ProximaAerospace/FlightComputersHardware/Main_Board/3D Models/THVD1450DRBR.stp

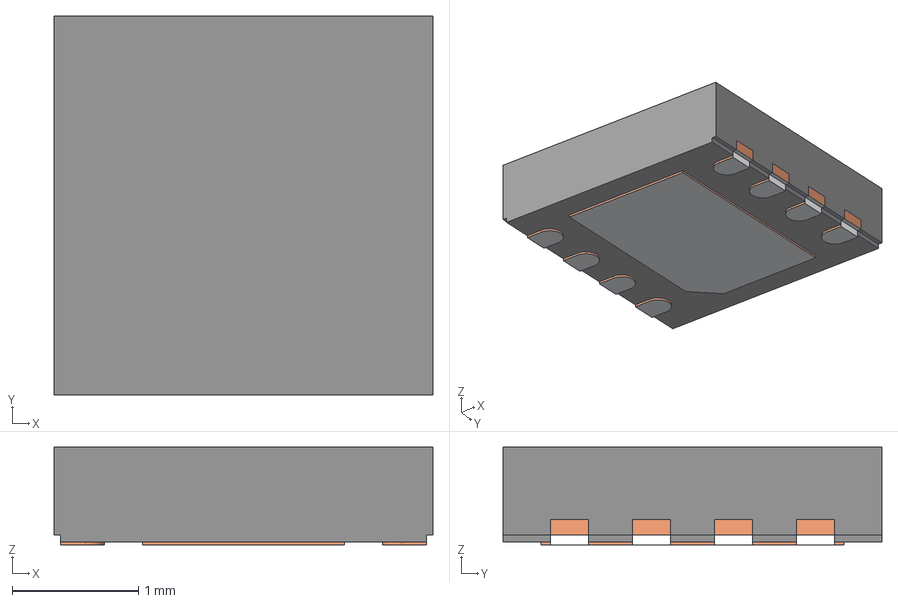
[picture p1: CAD file, 2026-09-14]
Main_Board/3D Models/THVD1450DRBR.stp
3.00 x 3.00 x 0.775 mm
BODY-SON_AF0
FRAME-DRB0008F_AF0
