ProximaAerospace/FlightComputersHardware/Main_Board/3D Models/LQH3NPN1R5MJRL.STEP

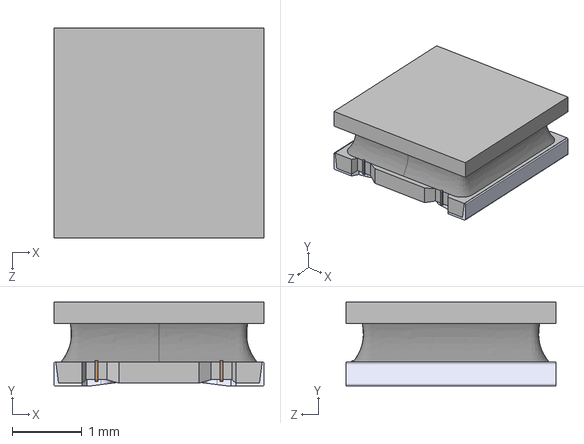
[picture p2: CAD file, 2026-08-05]
Main_Board/3D Models/LQH3NPN1R5MJRL.STEP
3.00 x 1.20 x 3.00 mm
