ProximaAerospace/FlightComputersHardware/Main_Board/3D Models/ESP32-S3-MINI-1U-N8--3DModel-STEP-56544.STEP

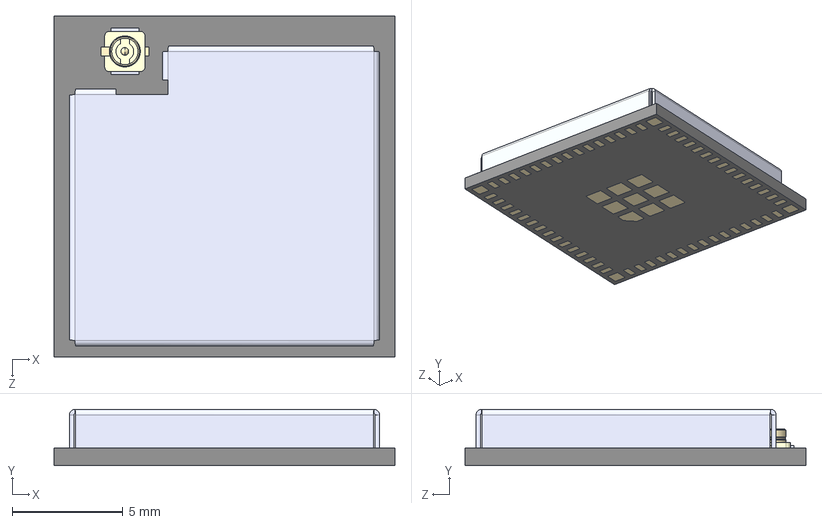
[picture p3: CAD file, 2026-08-05]
Main_Board/3D Models/ESP32-S3-MINI-1U-N8--3DModel-STEP-56544.STEP
15.4 x 2.55 x 15.4 mm
ESP32-S3-MINI-1U-N8_ESP32-C3-MINI-1-N4
antenna jack
