ProximaAerospace/FlightComputersHardware/Main_Board/Main_Board.kicad_pcb

## KiCad design Main_Board/Main_Board.kicad_pcb (2026-09-14)

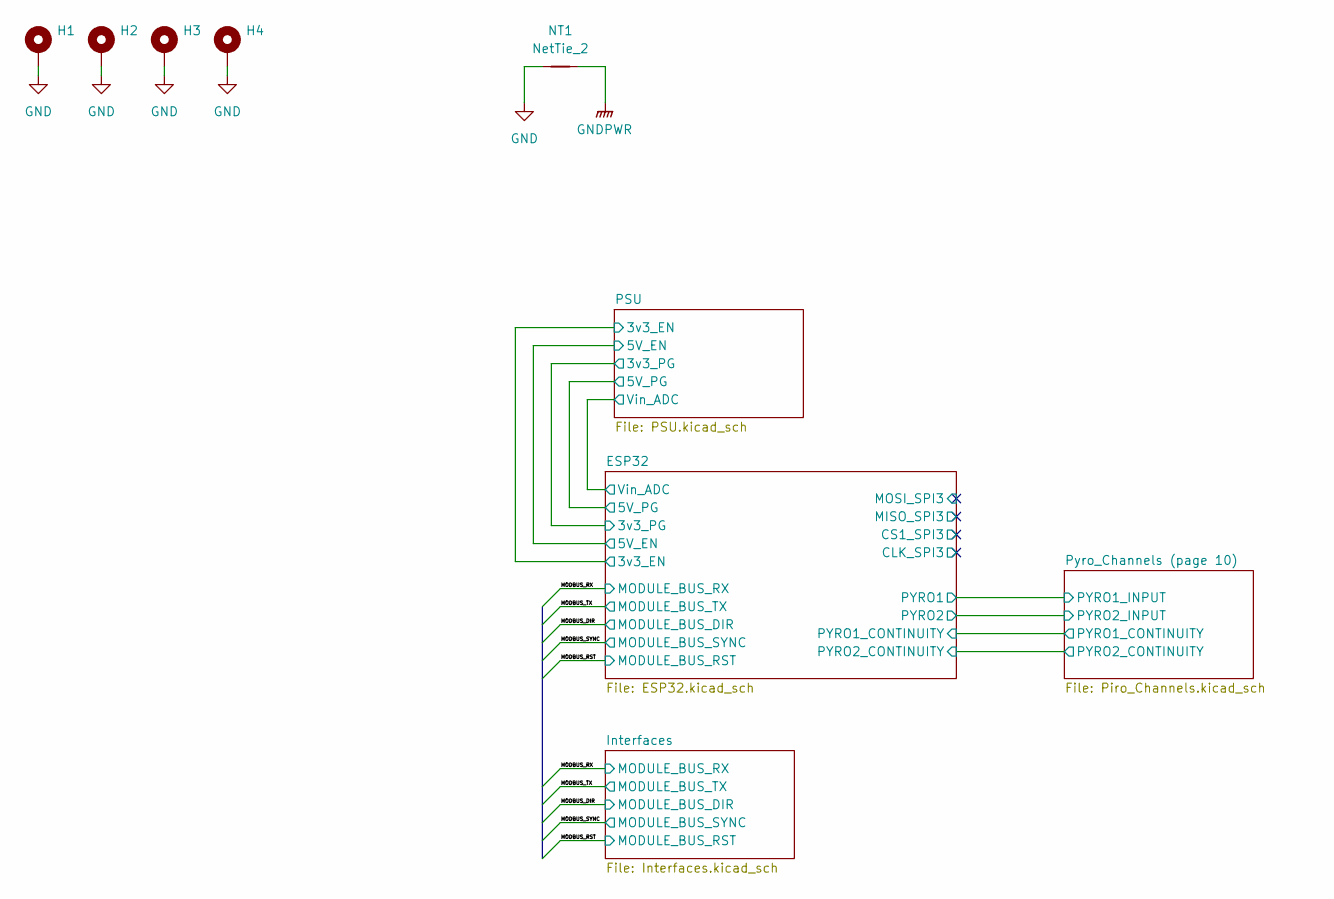
[picture p4: schematic Main_Board.kicad_sch]

Parts:
H1, H2: MountingHole_Pad; MountingHole_3.2mm_M3_DIN965_Pad_TopBottom
H3, H4: MountingHole_Pad; MountingHole_2.2mm_M2
NT1: NetTie_2; NetTie-2_SMD_Pad2.0mm

Connections:
GND: H1.1 (1_1), H2.1 (1_1), H3.1, H4.1, NT1.1; also elsewhere on the board
GNDPWR: NT1.2; also elsewhere on the board

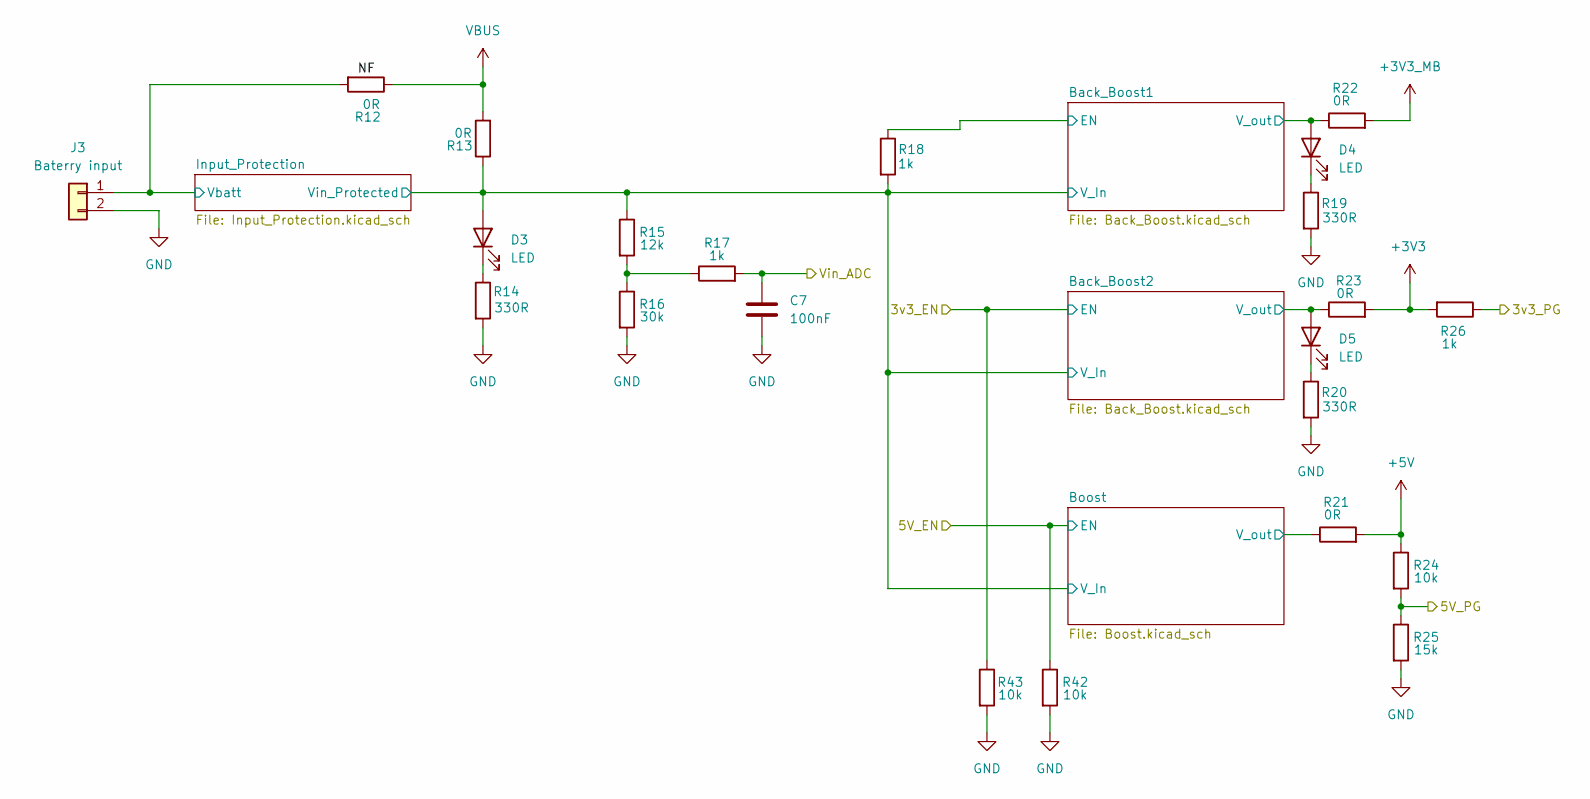
[picture p5: schematic PSU.kicad_sch]

Parts:
C7: 100nF; C_0603_1608Metric
D3, D4, D5: LED; D_0603_1608Metric
J3: Baterry input; JST_PH_B2B-PH-K_1x02_P2.00mm_Vertical
R12, R21, R22, R23: 0R; R_0603_1608Metric
R13: 0R; R_0805_2012Metric
R14, R19, R20: 330R; R_0603_1608Metric
R15: 12k; R_0603_1608Metric
R16: 30k; R_0603_1608Metric
R17, R18, R26: 1k; R_0603_1608Metric
R24, R42, R43: 10k; R_0603_1608Metric
R25: 15k; R_0603_1608Metric

Connections:
+3V3: R23.2, R26.2; also elsewhere on the board
+3V3_MB: R22.2; also elsewhere on the board
+5V: R21.2, R24.1; also elsewhere on the board
/ESP32/3v3_EN: R43.1; also elsewhere on the board
/ESP32/3v3_PG: R26.1; also elsewhere on the board
/ESP32/5V_EN: R42.1; also elsewhere on the board
/ESP32/5V_PG: R24.2, R25.1; also elsewhere on the board
/ESP32/Vin_ADC: C7.1, R17.2; also elsewhere on the board
/PSU/Back_Boost1/EN: R18.1; also elsewhere on the board
/PSU/Back_Boost1/V_In: D3.2 (A), R13.1, R15.1, R18.2; also elsewhere on the board
/PSU/Back_Boost1/V_out: D4.2 (A), R22.1; also elsewhere on the board
/PSU/Back_Boost2/V_out: D5.2 (A), R23.1; also elsewhere on the board
/PSU/Boost/V_out: R21.1; also elsewhere on the board
/PSU/Input_Protection/Vbatt: J3.1, R12.2; also elsewhere on the board
GND: C7.2, J3.2, R14.2, R16.2, R19.2, R20.2, R25.2, R42.2, R43.2; also elsewhere on the board
unnamed: D3.1 (K), R14.1
unnamed: D4.1 (K), R19.1
unnamed: D5.1 (K), R20.1
unnamed: R15.2, R16.1, R17.1
VBUS: R12.1, R13.2; also elsewhere on the board

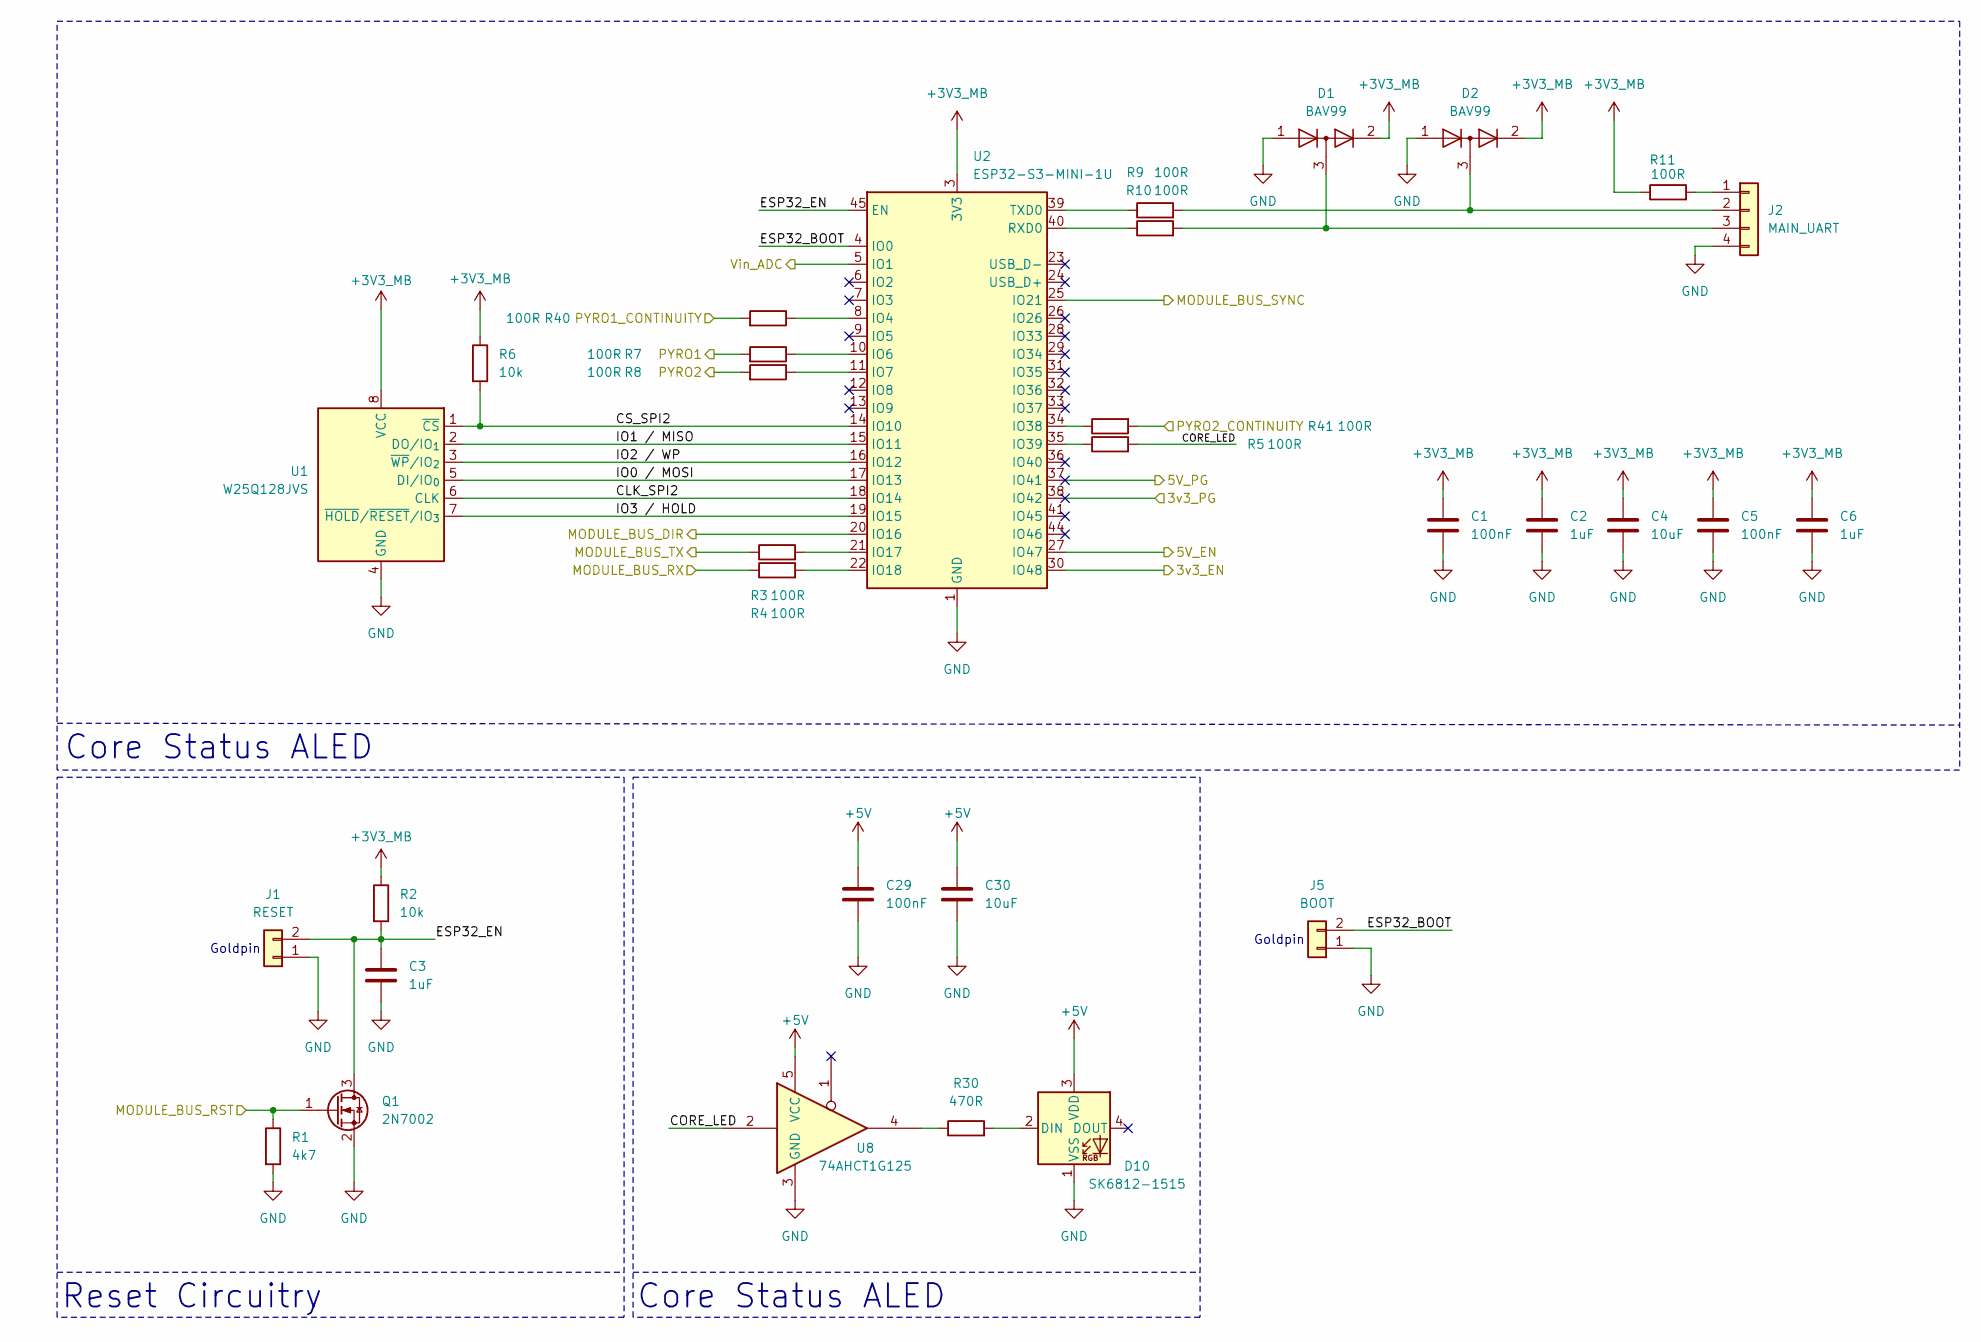
[picture p6: schematic ESP32.kicad_sch]

Parts:
C1, C5, C29: 100nF; C_0603_1608Metric
C2, C3, C6: 1uF; C_0603_1608Metric
C4, C30: 10uF; C_0603_1608Metric
D1, D2: BAV99; SOT-23
D10: SK6812-1515; sk68015-1515
J1: RESET; PinHeader_1x02_P1.27mm_Vertical
J2: MAIN_UART; PinHeader_1x04_P2.54mm_Vertical
J5: BOOT; PinHeader_1x02_P1.27mm_Vertical
Q1: 2N7002; SOT-23
R1: 4k7; R_0603_1608Metric
R2, R6: 10k; R_0603_1608Metric
R3, R4, R5, R7, R8, R9, R10, R11, R40, R41: 100R; R_0603_1608Metric
R30: 470R; R_0603_1608Metric
U1: W25Q128JVS; SOIC-8_5.3x5.3mm_P1.27mm
U2: ESP32-S3-MINI-1U; ESP32-S2-MINI-1U
U8: 74AHCT1G125; SOT-353_SC-70-5

Connections:
+3V3_MB: C1.1, C2.1, C4.1, C5.1, C6.1, D1.2 (A), D2.2 (A), R2.1, R6.1, R11.1, U1.8 (VCC), U2.3 (3V3); also elsewhere on the board
+5V: C29.1, C30.1, D10.3 (VDD), U8.5 (VCC); also elsewhere on the board
/ESP32/3v3_EN: U2.30 (IO48); also elsewhere on the board
/ESP32/3v3_PG: U2.38 (IO42); also elsewhere on the board
/ESP32/5V_EN: U2.27 (IO47); also elsewhere on the board
/ESP32/5V_PG: U2.37 (IO41); also elsewhere on the board
/ESP32/CLK_SPI2: U1.6 (CLK), U2.18 (IO14)
/ESP32/CORE_LED: R5.2, U8.2
/ESP32/CS_SPI2: R6.2, U1.1 (~CS), U2.14 (IO10)
/ESP32/ESP32_BOOT: J5.2, U2.4 (IO0)
/ESP32/ESP32_EN: C3.1, J1.2, Q1.3 (D), R2.2, U2.45 (EN)
/ESP32/IO0 / MOSI: U1.5 (DI/IO_{0}), U2.17 (IO13)
/ESP32/IO1 / MISO: U1.2 (DO/IO_{1}), U2.15 (IO11)
/ESP32/IO2 / WP: U1.3 (~WP/IO_{2}), U2.16 (IO12)
/ESP32/IO3 / HOLD: U1.7 (~HOLD/~RESET/IO_{3}), U2.19 (IO15)
/ESP32/PYRO1: R7.2; also elsewhere on the board
/ESP32/PYRO1_CONTINUITY: R40.2; also elsewhere on the board
/ESP32/PYRO2: R8.2; also elsewhere on the board
/ESP32/PYRO2_CONTINUITY: R41.2; also elsewhere on the board
/ESP32/Vin_ADC: U2.5 (IO1); also elsewhere on the board
/MODBUS_DIR: U2.20 (IO16); also elsewhere on the board
/MODBUS_RST: Q1.1 (G), R1.1; also elsewhere on the board
/MODBUS_RX: R4.1; also elsewhere on the board
/MODBUS_SYNC: U2.25 (IO21); also elsewhere on the board
/MODBUS_TX: R3.1; also elsewhere on the board
GND: C1.2, C2.2, C3.2, C4.2, C5.2, C6.2, C29.2, C30.2, D1.1 (K), D2.1 (K), D10.1 (VSS), J1.1, J2.4, J5.1, Q1.2 (S), R1.2, U1.4 (GND), U2.1 (GND), U2.2 (GND), U2.42 (GND), U2.43 (GND), U2.46 (GND), U2.47 (GND), U2.48 (GND), U2.49 (GND), U2.50 (GND), U2.51 (GND), U2.52 (GND), U2.53 (GND), U2.54 (GND), U2.55 (GND), U2.56 (GND), U2.57 (GND), U2.58 (GND), U2.59 (GND), U2.60 (GND), U2.61 (GND), U2.62 (GND), U2.63 (GND), U2.64 (GND), U2.65 (GND), U8.3 (GND); also elsewhere on the board
unnamed: D10.2 (DIN), R30.2
unnamed: J2.1, R11.2
unnamed: D2.3 (K), J2.2, R9.2
unnamed: D1.3 (K), J2.3, R10.2
unnamed: R30.1, U8.4
unnamed: R40.1, U2.8 (IO4)
unnamed: R7.1, U2.10 (IO6)
unnamed: R8.1, U2.11 (IO7)
unnamed: R3.2, U2.21 (IO17)
unnamed: R4.2, U2.22 (IO18)
unnamed: R41.1, U2.34 (IO38)
unnamed: R5.1, U2.35 (IO39)
unnamed: R10.1, U2.40 (RXD0)
unnamed: R9.1, U2.39 (TXD0)

Notes on the sheet:
Reset Circuitry
Goldpin
Core Status ALED

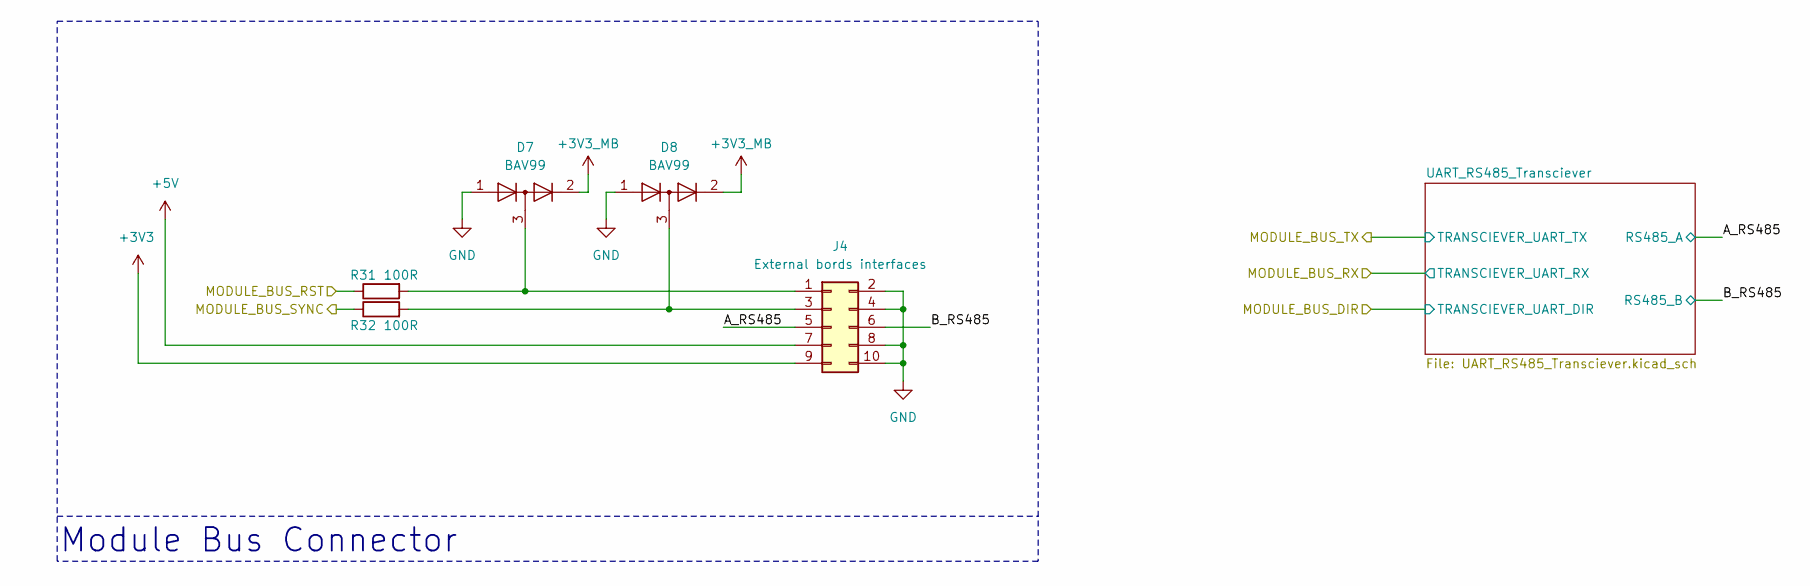
[picture p7: schematic Interfaces.kicad_sch]

Parts:
D7, D8: BAV99; SOT-23
J4: External bords interfaces; PinHeader_2x05_P1.27mm_Vertical
R31, R32: 100R; R_0603_1608Metric

Connections:
+3V3: J4.9; also elsewhere on the board
+3V3_MB: D7.2 (A), D8.2 (A); also elsewhere on the board
+5V: J4.7; also elsewhere on the board
/Interfaces/A_RS485: J4.5; also elsewhere on the board
/Interfaces/B_RS485: J4.6; also elsewhere on the board
/MODBUS_RST: R31.1; also elsewhere on the board
/MODBUS_SYNC: R32.1; also elsewhere on the board
GND: D7.1 (K), D8.1 (K), J4.2, J4.4, J4.8, J4.10; also elsewhere on the board
unnamed: D7.3 (K), J4.1, R31.2
unnamed: D8.3 (K), J4.3, R32.2

Notes on the sheet:
Module Bus Connector

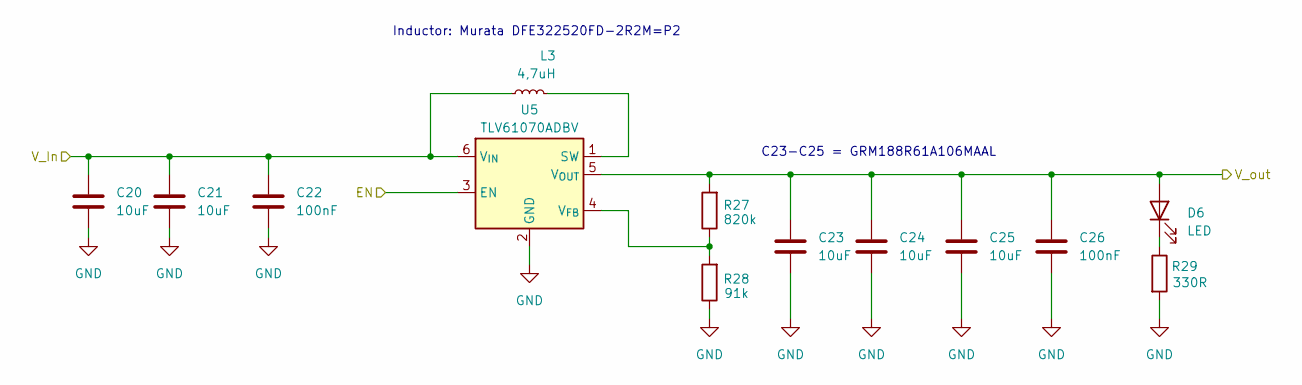
[picture p8: schematic Boost.kicad_sch]

Parts:
C20, C21, C23, C24, C25: 10uF; C_0603_1608Metric
C22, C26: 100nF; C_0603_1608Metric
D6: LED; D_0603_1608Metric
L3: 4,7uH; L_1210_3225Metric
R27: 820k; R_0603_1608Metric
R28: 91k; R_0603_1608Metric
R29: 330R; R_0603_1608Metric
U5: TLV61070ADBV; SOT-23-6

Connections:
/ESP32/5V_EN: U5.3 (EN); also elsewhere on the board
/PSU/Back_Boost1/V_In: C20.1, C21.1, C22.1, L3.2, U5.6 (V_{IN}); also elsewhere on the board
/PSU/Boost/V_out: C23.1, C24.1, C25.1, C26.1, D6.2 (A), R27.2, U5.5 (V_{OUT}); also elsewhere on the board
GND: C20.2, C21.2, C22.2, C23.2, C24.2, C25.2, C26.2, R28.1, R29.2, U5.2 (GND); also elsewhere on the board
unnamed: D6.1 (K), R29.1
unnamed: L3.1, U5.1 (SW)
unnamed: R27.1, R28.2, U5.4 (V_{FB})

Notes on the sheet:
Inductor: Murata DFE322520FD-2R2M=P2
C23-C25 = GRM188R61A106MAAL

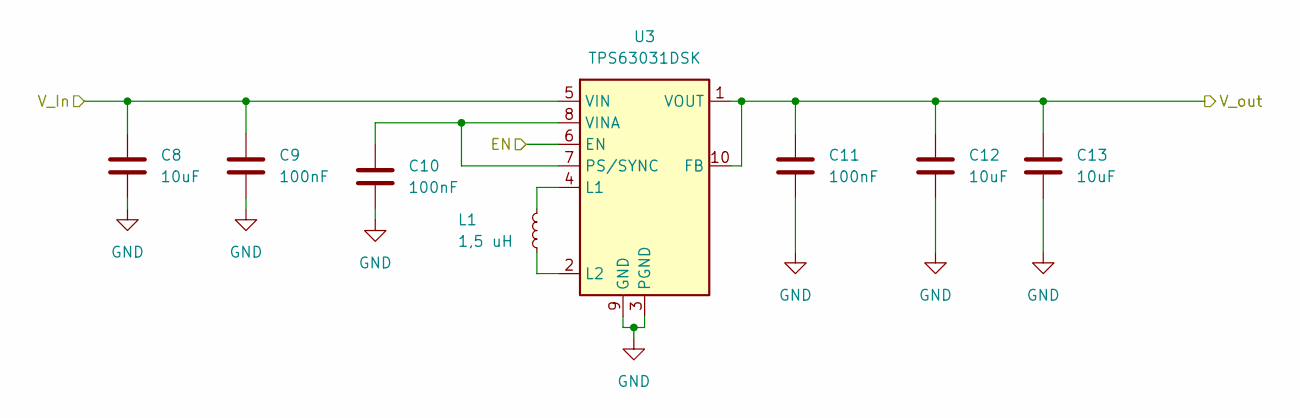
[picture p9: schematic Back_Boost.kicad_sch]

Parts:
C8, C12, C13: 10uF; C_0603_1608Metric
C9, C10, C11: 100nF; C_0603_1608Metric
L1: 1,5 uH; L_Taiyo-Yuden_MD-3030
U3: TPS63031DSK; WSON-10-1EP_2.5x2.5mm_P0.5mm_EP1.2x2mm

Connections:
/PSU/Back_Boost1/EN: U3.6 (EN); also elsewhere on the board
/PSU/Back_Boost1/V_In: C8.1, C9.1, U3.5 (VIN); also elsewhere on the board
/PSU/Back_Boost1/V_out: C11.1, C12.1, C13.1, U3.1 (VOUT), U3.10 (FB); also elsewhere on the board
GND: C8.2, C9.2, C10.2, C11.2, C12.2, C13.2, U3.3 (PGND), U3.9 (GND), U3.11 (PGND); also elsewhere on the board
unnamed: L1.1, U3.4 (L1)
unnamed: L1.2, U3.2 (L2)
unnamed: C10.1, U3.7 (PS/SYNC), U3.8 (VINA)

Parts of its further copies:
C14, C18, C19: 10uF; C_0603_1608Metric
C15, C16, C17: 100nF; C_0603_1608Metric
L2: 1,5 uH; L_Taiyo-Yuden_MD-3030
U4: TPS63031DSK; WSON-10-1EP_2.5x2.5mm_P0.5mm_EP1.2x2mm

Connections of its further copies:
/ESP32/3v3_EN: U4.6 (EN); also elsewhere on the board
/PSU/Back_Boost1/V_In: C14.1, C15.1, U4.5 (VIN); also elsewhere on the board
/PSU/Back_Boost2/V_out: C17.1, C18.1, C19.1, U4.1 (VOUT), U4.10 (FB); also elsewhere on the board
GND: C14.2, C15.2, C16.2, C17.2, C18.2, C19.2, U4.3 (PGND), U4.9 (GND), U4.11 (PGND); also elsewhere on the board
unnamed: L2.1, U4.4 (L1)
unnamed: L2.2, U4.2 (L2)
unnamed: C16.1, U4.7 (PS/SYNC), U4.8 (VINA)

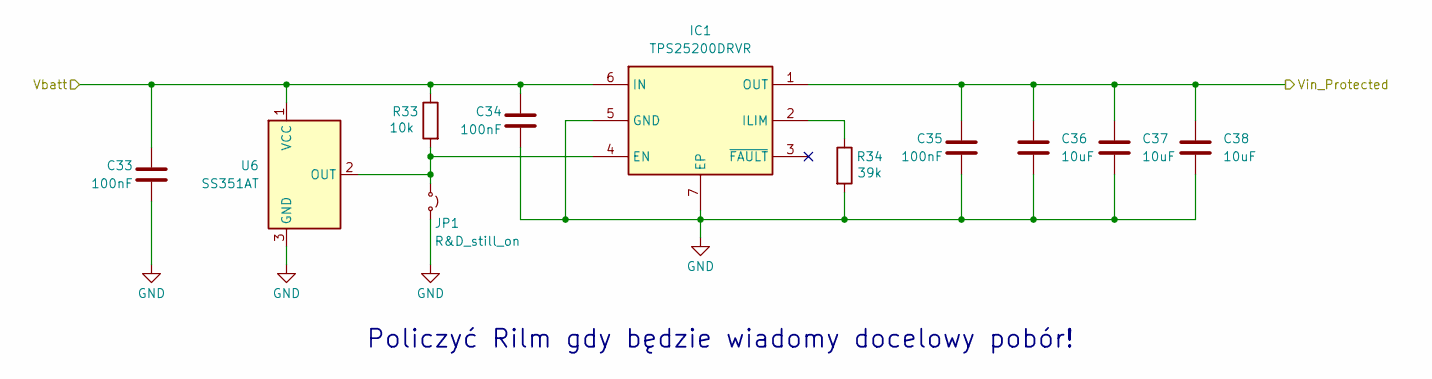
[picture p10: schematic Input_Protection.kicad_sch]

Parts:
C33, C34, C35: 100nF; C_0603_1608Metric
C36, C37, C38: 10uF; C_0603_1608Metric
IC1: TPS25200DRVR; SON65P200X200X80-7N; Manufacturer_Part_Number TPS25200DRVR; Mouser Part Number 595-TPS25200DRVR
JP1: R&D_still_on; SolderJumper-2_P1.3mm_Open_RoundedPad1.0x1.5mm
R33: 10k; R_0603_1608Metric
R34: 39k; R_0603_1608Metric
U6: SS351AT; SOT-23

Connections:
/PSU/Back_Boost1/V_In: C35.1, C36.1, C37.1, C38.1, IC1.1 (OUT); also elsewhere on the board
/PSU/Input_Protection/Vbatt: C33.1, C34.1, IC1.6 (IN), R33.1, U6.1 (VCC); also elsewhere on the board
GND: C33.2, C34.2, C35.2, C36.2, C37.2, C38.2, IC1.5 (GND), IC1.7 (EP), JP1.2 (B), R34.2, U6.3 (GND); also elsewhere on the board
unnamed: IC1.4 (EN), JP1.1 (A), R33.2, U6.2 (OUT)
unnamed: IC1.2 (ILIM), R34.1

Notes on the sheet:
Policzyć Rilm gdy będzie wiadomy docelowy pobór!

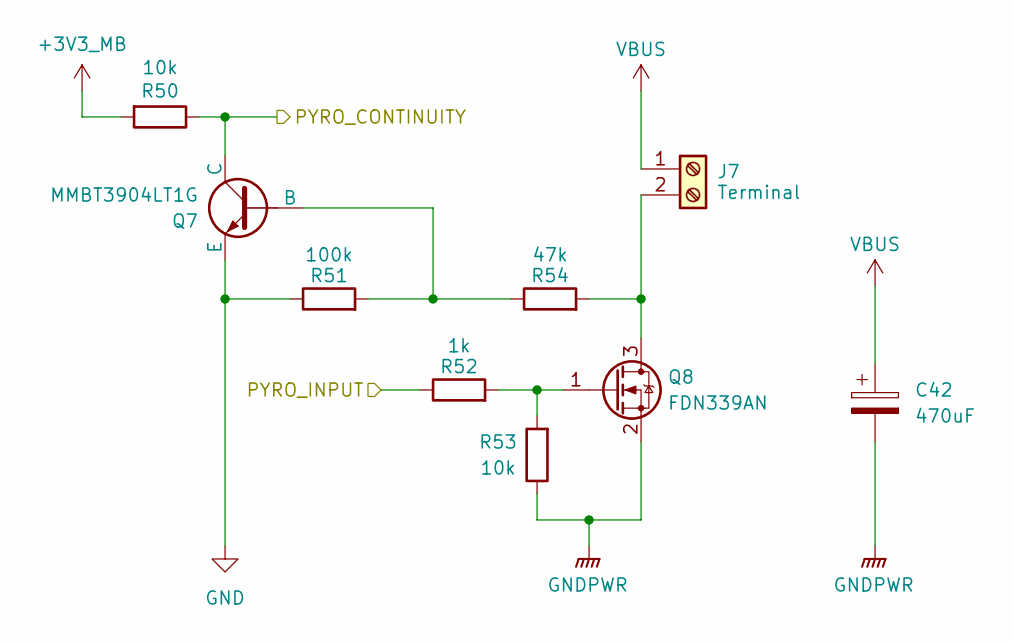
[picture p11: schematic PyroChannel1.kicad_sch]

Parts:
C42: 470uF; CP_Elec_8x10
J7: Terminal; SHDR2W80P0X381_1X2_841X700X920P
Q7: MMBT3904LT1G; SOT-23
Q8: FDN339AN; SOT-23
R50, R53: 10k; R_0603_1608Metric
R51: 100k; R_0603_1608Metric
R52: 1k; R_0603_1608Metric
R54: 47k; R_0603_1608Metric

Connections:
+3V3_MB: R50.2; also elsewhere on the board
/ESP32/PYRO1: R52.1; also elsewhere on the board
/ESP32/PYRO1_CONTINUITY: Q7.3 (C), R50.1; also elsewhere on the board
GND: Q7.2 (E), R51.1; also elsewhere on the board
GNDPWR: C42.2, Q8.2 (S), R53.1; also elsewhere on the board
unnamed: J7.2, Q8.3 (D), R54.2
unnamed: Q7.1 (B), R51.2, R54.1
unnamed: Q8.1 (G), R52.2, R53.2
VBUS: C42.1, J7.1; also elsewhere on the board

Parts of its further copies:
C43: 470uF; CP_Elec_8x10
J8: Terminal; SHDR2W80P0X381_1X2_841X700X920P
Q9: MMBT3904LT1G; SOT-23
Q10: FDN339AN; SOT-23
R55, R58: 10k; R_0603_1608Metric
R56: 100k; R_0603_1608Metric
R57: 1k; R_0603_1608Metric
R59: 47k; R_0603_1608Metric

Connections of its further copies:
+3V3_MB: R55.2; also elsewhere on the board
/ESP32/PYRO2: R57.1; also elsewhere on the board
/ESP32/PYRO2_CONTINUITY: Q9.3 (C), R55.1; also elsewhere on the board
GND: Q9.2 (E), R56.1; also elsewhere on the board
GNDPWR: C43.2, Q10.2 (S), R58.1; also elsewhere on the board
unnamed: J8.2, Q10.3 (D), R59.2
unnamed: Q9.1 (B), R56.2, R59.1
unnamed: Q10.1 (G), R57.2, R58.2
VBUS: C43.1, J8.1; also elsewhere on the board

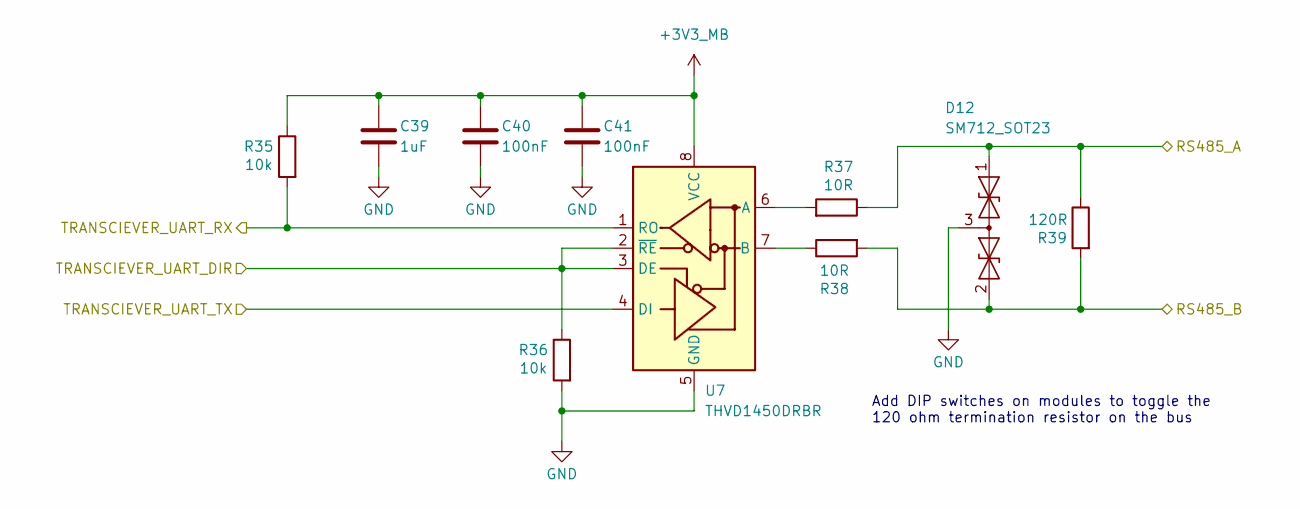
[picture p12: schematic UART_RS485_Transciever.kicad_sch]

Parts:
C39: 1uF; C_0603_1608Metric
C40, C41: 100nF; C_0603_1608Metric
D12: SM712_SOT23; SOT-23
R35, R36: 10k; R_0603_1608Metric
R37, R38: 10R; R_0603_1608Metric
R39: 120R; R_0603_1608Metric
U7: THVD1450DRBR; VSON-8-1EP_3x3mm_P0.65mm_EP1.6x2.4mm

Connections:
+3V3_MB: C39.1, C40.1, C41.1, R35.1, U7.8 (VCC); also elsewhere on the board
/Interfaces/A_RS485: D12.1 (A1), R37.1, R39.1; also elsewhere on the board
/Interfaces/B_RS485: D12.2 (A2), R38.2, R39.2; also elsewhere on the board
/MODBUS_DIR: R36.1, U7.2 (~RE), U7.3 (DE); also elsewhere on the board
/MODBUS_RX: R35.2, U7.1 (RO); also elsewhere on the board
/MODBUS_TX: U7.4 (DI); also elsewhere on the board
GND: C39.2, C40.2, C41.2, D12.3 (common), R36.2, U7.5 (GND); also elsewhere on the board
unnamed: R37.2, U7.6 (A)
unnamed: R38.1, U7.7 (B)

Notes on the sheet:
Add DIP switches on modules to toggle the 120 ohm termination resistor on the bus

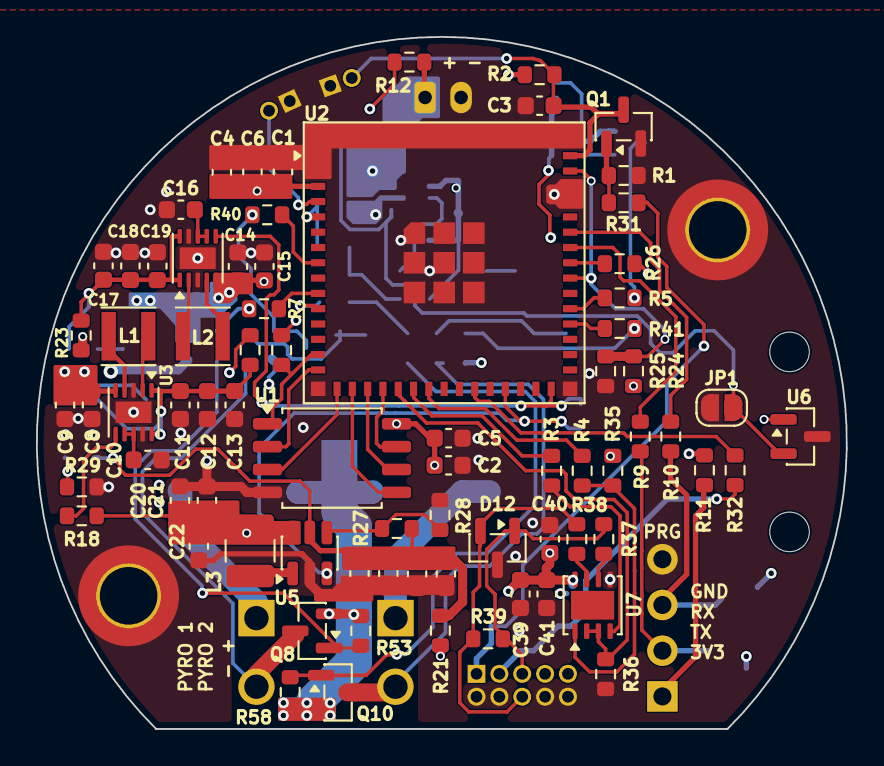
[picture p13: board Main_Board.kicad_pcb from above]

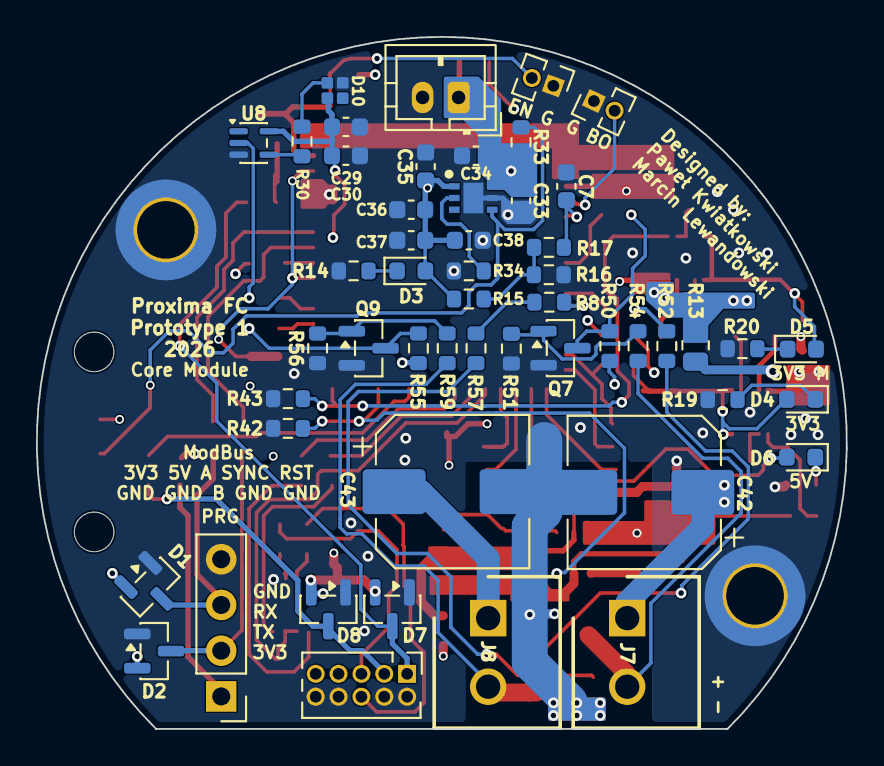
[picture p14: board Main_Board.kicad_pcb from below]

Board: 4 copper layers, 45.0 x 38.4 mm, 132 parts (53 on the bottom side), 76 nets.
