ProximaAerospace/FlightComputersHardware/(commit log)

2026-07-31 ESP32 initial
    [ESP32.kicad_sch, Main_Board.kicad_pcb, Main_Board.kicad_sch]
2026-07-31 PSU Ready + ESP32 advanced
    [Back_Boost.kicad_sch, Back_Boost1.kicad_sch, Boost.kicad_sch, ESP32.kicad_sch, Interfaces.kicad_sch, Main_Board.kicad_sch, PSU.kicad_sch, Power Menegment.kicad_sch]
2026-08-01 Input Protection
    Irlm is left to be calculated
    [Back_Boost.kicad_sch, Boost.kicad_sch, ESP32.kicad_sch, Input_Protection.kicad_sch, Main_Board.kicad_sch, PSU.kicad_sch]
2026-08-01 Input Protection Fix
    [Input_Protection.kicad_sch, PSU.kicad_sch]
2026-08-01 RS485 Transciever + Input Protection fix
    [ESP32.kicad_sch, Input_Protection.kicad_sch, Interfaces.kicad_sch, Main_Board.kicad_sch, PSU.kicad_sch, UART_RS485_Transciever.kicad_sch]
2026-08-01 add external obrds interfaces
    Todo pyro chanells
    [ESP32.kicad_sch, Input_Protection.kicad_sch, Interfaces.kicad_sch, Main_Board.kicad_sch, UART_RS485_Transciever.kicad_sch]
2026-08-01 Add mag sensor
    [Input_Protection.kicad_sch]
2026-08-02 Add buzzer, Add LED, ADD R&D jumper
    [Back_Boost.kicad_sch, Boost.kicad_sch, ESP32.kicad_sch, Input_Protection.kicad_sch, Interfaces.kicad_sch, Main_Board.kicad_sch, PSU.kicad_sch, UART_RS485_Transciever.kicad_sch]
2026-08-02 ADD footprints
    [Back_Boost.kicad_sch, Boost.kicad_sch, ESP32.kicad_sch, Input_Protection.kicad_sch, Interfaces.kicad_sch, PSU.kicad_sch, UART_RS485_Transciever.kicad_sch]
2026-08-02 PCB init
    [Back_Boost.kicad_sch, Interfaces.kicad_sch, Main_Board.kicad_pcb, Main_Board.kicad_sch, PSU.kicad_sch]
2026-08-02 sch update
    [ESP32.kicad_sch]
2026-08-02 Add pyro channels x2
    [Back_Boost.kicad_sch, Boost.kicad_sch, ESP32.kicad_sch, Input_Protection.kicad_sch, Interfaces.kicad_sch, Main_Board.kicad_sch, PSU.kicad_sch, Piro_Channels.kicad_sch]
2026-08-02 Module bus fix
    [ESP32.kicad_sch, Interfaces.kicad_sch, Main_Board.kicad_sch, Piro_Channels.kicad_sch]
2026-08-02 Update main sheet for pyros
    [ESP32.kicad_sch, Main_Board.kicad_sch, Piro_Channels.kicad_sch]
2026-08-02 Fix schematic readibility
    [Back_Boost.kicad_sch, Boost.kicad_sch, ESP32.kicad_sch, Input_Protection.kicad_sch, Interfaces.kicad_sch, Main_Board.kicad_sch, Piro_Channels.kicad_sch]
2026-08-02 Standardise resistor value mark for BOM + pyro footprints
    [Boost.kicad_sch, Input_Protection.kicad_sch, Main_Board.kicad_pcb, Piro_Channels.kicad_sch, UART_RS485_Transciever.kicad_sch]
2026-08-02 Pyro layout + schematic fix
    [Main_Board.kicad_pcb, Main_Board.kicad_sch, Piro_Channels.kicad_sch, PyroChannel1.kicad_sch]
2026-08-02 Change connector footprints
    [ESP32.kicad_sch, Interfaces.kicad_sch, Main_Board.kicad_pcb, Piro_Channels.kicad_sch, PyroChannel1.kicad_sch]
2026-08-02 Remove buzzer circuitry
    [ESP32.kicad_sch, Interfaces.kicad_sch, Main_Board.kicad_pcb, Piro_Channels.kicad_sch, PyroChannel1.kicad_sch]
2026-08-03 New footprints + layout
    [Main_Board.kicad_pcb, PyroChannel1.kicad_sch]
2026-08-03 Improve placement/layout
    RS485 layout fix, buck-boost, pyro
    [Main_Board.kicad_pcb, PSU.kicad_sch]
2026-08-03 Power Input Protection Layout
    [Main_Board.kicad_pcb]
2026-08-03 Input resistors, PRG, pour zones
    [Main_Board.kicad_pcb]
2026-08-03 Layout fix, group parts
    [Main_Board.kicad_pcb]
2026-08-05 Boost layout part 1
    [Main_Board.kicad_pcb]
2026-08-05 Fix boost schematic +layout
    [Boost.kicad_sch, Main_Board.kicad_pcb]
2026-08-05 PWR layout
    [Main_Board.kicad_pcb]
2026-08-05 layout + ESP 3D + spacing
    [ESP32-S3-MINI-1U-N8--3DModel-STEP-56544.STEP, Main_Board.kicad_pcb]
2026-08-05 Improve RS485 layout
    Still room for improvement though.
    [Main_Board.kicad_pcb]
2026-08-05 Fix + Inductors 3D models
    [LQH3NPN1R5MJRL.STEP, Main_Board.kicad_pcb]
2026-08-05 Small fix
    [Main_Board.kicad_pcb, PSU.kicad_sch]
2026-08-07 layout update
    [ESP32.kicad_sch, Interfaces.kicad_sch, Main_Board.kicad_pcb, PyroChannel1.kicad_sch]
2026-08-11 Pyro fix
    [Main_Board.kicad_pcb]
2026-08-12 fix piro + start power plane
    [Main_Board.kicad_pcb]
2026-08-14 memory fix + piro
    [ESP32.kicad_sch, Main_Board.kicad_pcb]
2026-08-15 Keep out zones, cleanup
    [Main_Board.kicad_pcb]
2026-08-15 Routing + cleanup
    [Main_Board.kicad_pcb]
2026-08-15 Schematic cleanup, ALED footprint + 3D + sch
    + layout and routing
    [ESP32.kicad_sch, Interfaces.kicad_sch, Main_Board.kicad_pcb, Piro_Channels.kicad_sch, PyroChannel1.kicad_sch]
2026-08-15 Unspaghettify flash schematic
    [ESP32.kicad_sch]
2026-08-15 Power routing
    [Main_Board.kicad_pcb]
2026-08-15 Pyro routing/layout fix
    [Main_Board.kicad_pcb]
2026-08-15 Cleanup + clearance fix
    [Main_Board.kicad_pcb]
2026-08-15 ModuleBus TVS clearance
    [Main_Board.kicad_pcb]
2026-08-16 ADC Vin ready
    [Main_Board.kicad_pcb]
2026-08-16 5V Ready
    [Main_Board.kicad_pcb]
2026-08-16 Mag Arm ready
    [Main_Board.kicad_pcb]
2026-08-24 LED, EN, Delete legacy
    [Main_Board.kicad_pcb]
2026-08-24 Routing cleanup
    [Main_Board.kicad_pcb]
2026-09-01 Routing, repin pyro continuity to IO38
    [ESP32.kicad_sch, Main_Board.kicad_pcb]
2026-09-01 Routing done
    [Main_Board.kicad_pcb]
2026-09-01 nettie add /gnd split
    [Main_Board.kicad_pcb, Main_Board.kicad_sch, PyroChannel1.kicad_sch]
2026-09-03 Begin silkscreen
    [Main_Board.kicad_pcb]
2026-09-07 Silkscreen, routing fix, pinout labels
    [Main_Board.kicad_pcb]
2026-09-08 Layout DRC errors
    + Silkscreen
    [Main_Board.kicad_pcb]
2026-09-08 Layout DRC Warnings
    [Main_Board.kicad_pcb]
2026-09-08 Schematic ERC
    [ESP32.kicad_sch, Main_Board.kicad_sch]
2026-09-09 Power plane fix + remove termal pads
    [Main_Board.kicad_pcb]
2026-09-13 BOOT + new EN and layout + silkscreen
    [ESP32.kicad_sch, Main_Board.kicad_pcb]
2026-09-13 Pyro fix + silk
    [Main_Board.kicad_pcb, PyroChannel1.kicad_sch]
2026-09-14 fix shema after review
    [ESP32.kicad_sch, Input_Protection.kicad_sch, PSU.kicad_sch]
2026-09-14 fix after review -?D7/D8 clamp to 3v3 MB not for 3v3 and other fix
    [ESP32.kicad_sch, Interfaces.kicad_sch, Main_Board.kicad_pcb, PSU.kicad_sch, UART_RS485_Transciever.kicad_sch]
2026-09-14 PCB update
    [Main_Board.kicad_pcb]
2026-09-14 ALED Level shifter, fix RS485 transciever IC naming
    [ESP32.kicad_sch, Main_Board.kicad_pcb, UART_RS485_Transciever.kicad_sch]
2026-09-14 New boost inductor (needs to be verified)
    [Boost.kicad_sch, Main_Board.kicad_pcb]
2026-09-14 Update layout, routing, sch and silkscreen
    After review
    [ESP32.kicad_sch, Main_Board.kicad_pcb]
2026-09-14 Cap note
    [Boost.kicad_sch]
2026-09-14 New resistors
    [Main_Board.kicad_pcb]
2026-09-14 Fix new inductor layout
    [Main_Board.kicad_pcb]
2026-09-14 Add missing THVD1450DRBR 3D Model
    [Main_Board.kicad_pcb, THVD1450DRBR.stp]
